Northeastern-Micromouse/Micromouse2019/Main Board/Project Outputs for Micromouse2019/Micromouse2019.xls

Component List |  |  | Bill of Materials For PCB Document [Micromouse2019.PcbDoc]
Source Data From: |  |  | Micromouse2019.PcbDoc
Project: |  |  | Micromouse2019.PrjPcb
Variant: |  |  | None
Report Date: |  | 2/5/2019 | 7:44:57 PM
Print Date: |  | 2019-02-05 | 20:02:51
Designator | Description | Supplier 1 | Supplier Part Number 1 | Quantity | Supplier Unit Price 1 | Total Price ($)
C1, C3, C4, C6, C7, C8 | CAP CER 1UF 25V X7R 0805 | Digi-Key | 490-4785-1-ND (https://octopart-clicks.com/click/altium?sku=490-4785-1-ND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) | 6 |  | $0.00
C2 | CAP CER 10UF 50V X5R 1206 | Digi-Key | 490-12456-1-ND (https://octopart-clicks.com/click/altium?sku=490-12456-1-ND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) | 1 |  | $0.00
C5 | CAP CER 4.7UF 10V X7R 0805 | Digi-Key | 1276-2972-1-ND (https://octopart-clicks.com/click/altium?sku=1276-2972-1-ND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) | 1 |  | $0.00
C9, C10, C13, C15, C19 | CAP CER 0.1UF 50V X7R 0603 | Digi-Key | 399-6856-1-ND (https://octopart-clicks.com/click/altium?sku=399-6856-1-ND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) | 5 |  | $0.00
C11, C12, C16, C20 | CAP TANT 10UF 10% 20V 1206 | Digi-Key | 478-8273-1-ND (https://octopart-clicks.com/click/altium?sku=478-8273-1-ND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) | 4 |  | $0.00
C14, C18 | CAP CER 10000PF 50V X7R 0603 | Digi-Key | 311-1085-1-ND (https://octopart-clicks.com/click/altium?sku=311-1085-1-ND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) | 2 |  | $0.00
C17, C21 | CAP CER 0.47UF 16V X7R 0603 | Digi-Key | 490-3295-1-ND (https://octopart-clicks.com/click/altium?sku=490-3295-1-ND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) | 2 |  | $0.00 | Alt: 1276-2082-1-ND‎
D1 | LED GREEN CLEAR CHIP SMD | Digi-Key | 160-1888-1-ND (https://octopart-clicks.com/click/altium?sku=160-1888-1-ND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) | 1 |  | $0.00
D2, D3, D4, D5 | LED BLUE CLEAR CHIP SMD | Digi-Key | 160-1647-1-ND (https://octopart-clicks.com/click/altium?sku=160-1647-1-ND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) | 4 |  | $0.00
J1 | CONN HEADER R/A 4POS 2.5MM | Digi-Key | 455-2243-ND (https://octopart-clicks.com/click/altium?sku=455-2243-ND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) | 1 |  | $0.00
J4, J8 | CONN HEADER 4POS .100 R/A 30AU | Digi-Key | 609-3312-ND (https://octopart-clicks.com/click/altium?sku=609-3312-ND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) | 2 |  | $0.00
J11, J12 | CONN HEADER R/A 12POS 2.54MM | Digi-Key | SAM8998-ND (https://octopart-clicks.com/click/altium?sku=SAM8998-ND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) | 2 |  | $0.00
Q1, Q2 | TRANS 2NPN PREBIAS 0.2W US6 | Digi-Key | RN1907LF(CTCT-ND (https://octopart-clicks.com/click/altium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) | 2 |  | $0.00
R1, R2, R4, R5, R6, R8, R9 | RES SMD 100 OHM 1% 1/10W 0603 | Digi-Key | 311-100HRCT-ND (https://octopart-clicks.com/click/altium?sku=311-100HRCT-ND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) | 7 |  | $0.00
R3 | RES SMD 499K OHM 1% 1/10W 0603 | Digi-Key | 311-499KHRCT-ND (https://octopart-clicks.com/click/altium?sku=311-499KHRCT-ND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) | 1 |  | $0.00
R7, R12, R17, R21, R31, R32 | RES SMD 10K OHM 5% 1/10W 0603 | Digi-Key | 311-10KGRCT-ND (https://octopart-clicks.com/click/altium?sku=311-10KGRCT-ND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) | 6 |  | $0.00
R10 | RES 0.05 OHM 1% 1W 2512 | Digi-Key | 311-0.05TCT-ND (https://octopart-clicks.com/click/altium?sku=311-0.05TCT-ND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) | 1 |  | $0.00
R11, R23, R24, R25, R26 | RES SMD 220 OHM 5% 1/10W 0603 | Digi-Key | 311-220GRCT-ND (https://octopart-clicks.com/click/altium?sku=311-220GRCT-ND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) | 5 |  | $0.00
R13, R14 | RES SMD 4.7K OHM 5% 1/10W 0603 | Digi-Key | 311-4.7KGRCT-ND (https://octopart-clicks.com/click/altium?sku=311-4.7KGRCT-ND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) | 2 |  | $0.00
R15, R16, R19, R20 | RES 0.1 OHM 1% 1/3W 0603 | Digi-Key | P17478CT-ND (https://octopart-clicks.com/click/altium?sku=P17478CT-ND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) | 4 |  | $0.00
R18, R22 | 10K Trimmer Potentiometer | Digi-Key | ST32ETB103CT-ND (https://octopart-clicks.com/click/altium?sku=ST32ETB103CT-ND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) | 2 |  | $0.00
R27, R28, R29, R30 | RES SMD 100K OHM 5% 1/10W 0603 | Digi-Key | 311-100KGRCT-ND (https://octopart-clicks.com/click/altium?sku=311-100KGRCT-ND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) | 4 |  | $0.00
SW1, SW2, SW3 | SWITCH TACTILE SPST-NO 0.05A 12V | Digi-Key | CKN9088CT-ND (https://octopart-clicks.com/click/altium?sku=CKN9088CT-ND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) | 3 |  | $0.00
U1 | IC BATT MGMT LI-ION AFE 20TSSOP | Digi-Key | 296-39960-1-ND (https://octopart-clicks.com/click/altium?sku=296-39960-1-ND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) | 1 |  | $0.00
U2 | DC DC CONVERTER 5V | Digi-Key | 945-3042-ND (https://octopart-clicks.com/click/altium?sku=945-3042-ND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) | 1 |  | $0.00
U4, U5 | IC MOTOR DRIVER PAR 28HTSSOP | Digi-Key | 296-29503-1-ND (https://octopart-clicks.com/click/altium?sku=296-29503-1-ND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) | 2 |  | $0.00
U6 | SPARKFUN 9 DEGREES OF FREEDOM IM | Digi-Key | 1568-1257-ND (https://octopart-clicks.com/click/altium?sku=1568-1257-ND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) | 1 |  | $0.00
 |  |  |  |  | TOTAL PRICE | $0.00
