Northeastern-Micromouse/Micromouse2019/CAD/pololu-universal-aluminum-mounting-hub-for-5mm-shaft-4-40-holes.step

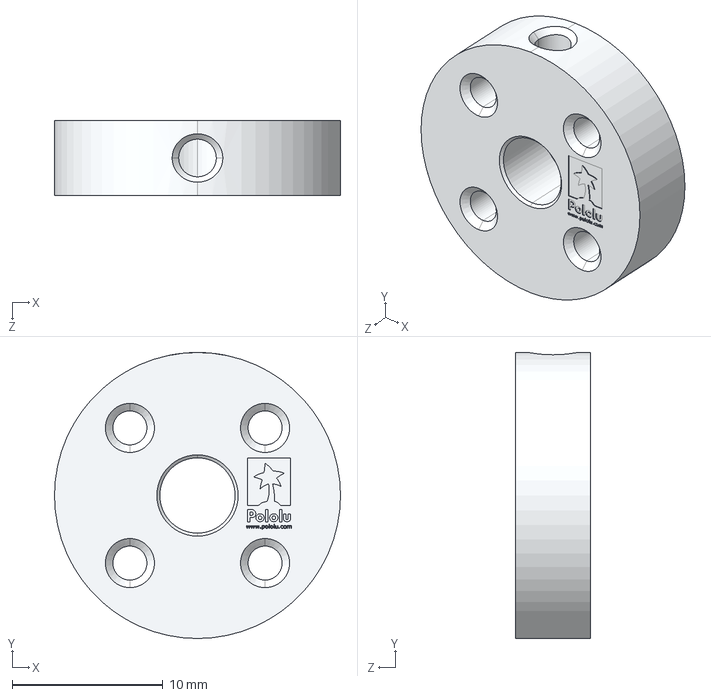
[picture p1: CAD file, 2019-02-21]
CAD/pololu-universal-aluminum-mounting-hub-for-5mm-shaft-4-40-holes.step
19.0 x 19.0 x 5.00 mm
