Northeastern-Micromouse/Micromouse2019/CAD/pololu-wheel-60×8mm/pololu-wheel-60x8mm-white.step

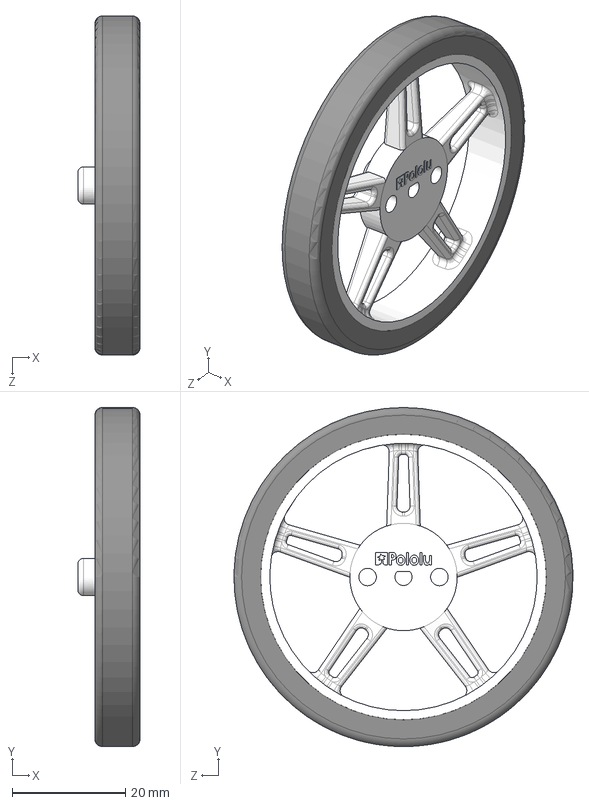
[picture p2: CAD file, 2019-02-21]
CAD/pololu-wheel-60×8mm/pololu-wheel-60x8mm-white.step
11.0 x 60.0 x 60.0 mm
