Northeastern-Micromouse/Micromouse2019/Sensor Board/Sensor Board.step

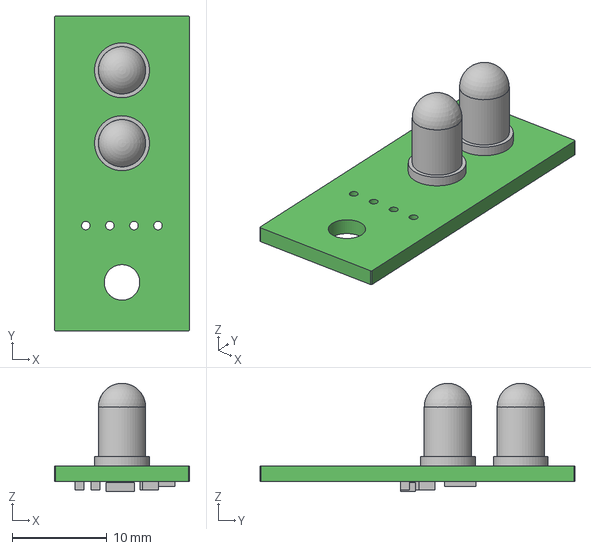
[picture p3: CAD file, 2019-02-21]
Sensor Board/Sensor Board.step
14.3 x 33.3 x 11.4 mm
