Northeastern-Micromouse/Micromouse2019/(list of files, cad)

Other CAD files:
CAD/pololu-wheel-60×8mm/pololu-wheel-60x8mm-yellow.step
CAD/pololu-wheel-60×8mm/pololu-wheel-60x8mm-red.step
CAD/pololu-wheel-60×8mm/pololu-wheel-60x8mm-blue.step
CAD/pololu-wheel-60×8mm/pololu-wheel-60x8mm-black.step
CAD/14HM08 Chassis Flat Bottom.ipt
CAD/14HM08 Chassis Sleds.ipt
CAD/14HM08 Chassis.ipt
CAD/14HM08.ipt
CAD/14HM11 Chassis.ipt
CAD/14HM11.ipt
CAD/Angled Sensor Mount Base.ipt
CAD/Angled Sensor Mount.ipt
CAD/Battery Restraint.ipt
CAD/Maze Wall Alignment Jig.ipt
CAD/Maze Wall Cut Jig.ipt
CAD/Maze Wall Middle.ipt
CAD/Maze Wall Post.ipt
CAD/Maze Wall.ipt
CAD/Micromouse 2019 (14HM08).iam
CAD/Micromouse 2019 (14HM11).iam
CAD/Sensor Calibration Rail Carriage.ipt
CAD/Sensor Calibration Rail Wall Support.ipt
CAD/Sensor Calibration Rail.ipt
CAD/Sensor Cover 6mm.ipt
CAD/Sensor Cover 7mm.ipt
CAD/Sensor Cover 8mm.ipt
CAD/Sensor Cover 9mm.ipt
CAD/pololu-universal-aluminum-mounting-hub-for-5mm-shaft-4-40-holes.ipt
CAD/pololu-wheel-60×8mm/pololu-wheel-60x8mm-black.ipt
Sensor Board/Sensor Board.ipt
