Northeastern-Micromouse/Micromouse2019/(list of files, drawings)

Other design files:
Main Board/Battery Management.SchDoc
Main Board/Beaglebone.SchDoc
Main Board/Micromouse2019.PcbDoc
Main Board/Micromouse2019.PrjPcb
Main Board/MicromouseLib.PcbLib
Main Board/MicromouseLib.SchLib
Main Board/Motor Drivers.SchDoc
Main Board/Peripherals.SchDoc
Sensor Board/TSFF5210.PcbDoc
Sensor Board/TSFF5210.PrjPCB
Sensor Board/TSFF5210.SchDoc
Sensor Board/Zhe_Micromouse_Lib.PcbLib
Sensor Board/Zhe_Micromouse_Lib.SchLib
