Northeastern-Micromouse/Micromouse2019/Software/Main/include/PID.h

#ifndef PID_H
#define PID_H

namespace micromouse {

class PID {
	
public:
	PID(float kp, float ki, float kd);
	float update(float error, float dt);
	void reset();

private:
	float _ki;
	float _kp;
	float _kd;
	float _previousError;
	float _integralError;
	
};

}

#endif
