Northeastern-Micromouse/Micromouse2019/Software/Main/include/motors.h

#ifndef	MOTORS_H
#define MOTORS_H

#define MOTOR_FORWARD 1
#define MOTOR_BACKWARD 0

#define MOTOR_INVERT_LEFT 0
#define MOTOR_INVERT_RIGHT 1

#include "../../PRU/PRU0/pru_motorcontrol.h"
#include "gpioDevice.h"

namespace micromouse {
	
class MotorSystem {
	
public:
	MotorSystem(volatile unsigned int* pru_mem,
				GpioDevice* leftDirPin,
				GpioDevice* rightDirPin,
				GpioDevice* enablePin);
	
	int init(unsigned int timeout);
	void enable();
	void disable();
	int drive(unsigned int stepsLeft,
				unsigned int stepsRight,
				unsigned int periodLeft,
				unsigned int periodRight,
				bool directionLeft,
				bool directionRight,
				unsigned int timeout);
	
private:
	volatile unsigned int* _pru_mem;
	GpioDevice* _leftDirPin;
	GpioDevice* _rightDirPin;
	GpioDevice* _enablePin;
};

}

#endif
