Northeastern-Micromouse/Micromouse2019/(commit log)

2019-02-22 updated drive
    [Micromouse2019.xls]
2019-03-04 Tuning stage
    [14HM08 Chassis Sleds.ipt, 14HM08 Chassis.ipt, Micromouse 2019 (14HM08).iam]
2019-03-07 fixed some mapping bugs
    [AlgoRobot.cc, AlgoRobot.h, Maze.cc, main.cc]
2019-03-07 More granular drift correction
    [robot.cc, robot.h]
2019-03-09 buttons during backtracking
2019-03-09 Competition calibration
